torqu3e/Bonafizy/README.md

# Bonafizy

A project enabling control of Bonavita variable temperature kettles remotely over wifi. It adds an ESP8266 based wifi stack that runs a bit of C code to expose an HTTP REST API endpoint.

There's support to control both power and hold buttons individually as well as read the power or hold LED status. Bonafizy responds back with a JSON body making it easy to parse the output.

```
$ curl kettle.local/brew
{"message": "Brewing now!!!", "state": {"power": 1, "hold": 1}}
```

```
$ curl kettle.local/state
{"version": "0.1.2_mdns", "state": {"power": 0, "hold": 0}}
```

The name bonafizy is a portmanteau of Bonavita, WiFi and lazy. And by lazy I mean smart and resourceful :)

## Features
* Existent buttons continue to function
  * Kettle's in-built safety mechanisms still valid
* Control both POWER and HOLD individually
* Read both POWER and HOLD LED state
* Switch power and hold on with one request
* Wifi config via initial setup
* OTA updates
* mDNS

## Parts list
* [Bonavita kettle](https://bonavitaworld.com/products/category/Kettles) (of course). - 1
* [Wemos D1 Mini](https://www.aliexpress.com/item/32529101036.html) - 1
* [SparkFun Opto-isolator Breakout](https://www.sparkfun.com/products/9118) - 2
* Power Supply Unit [HLK-PM01](https://www.aliexpress.com/wholesale?catId=0&initiative_id=SB_20200329071832&SearchText=hlk+pm01) or a tiny USB adapter (old iPhone one?) - 1

## Tools and consumables
* Y1 screwdriver bit. iFixit has some good kits
* Jumper wires - few, ideally in different colours
* Micro usb cable
* Heatshrink tubing
* Hot glue gun
* Soldering iron, solder, flux, wire snips yada yada yada...

## Wiring Diagram
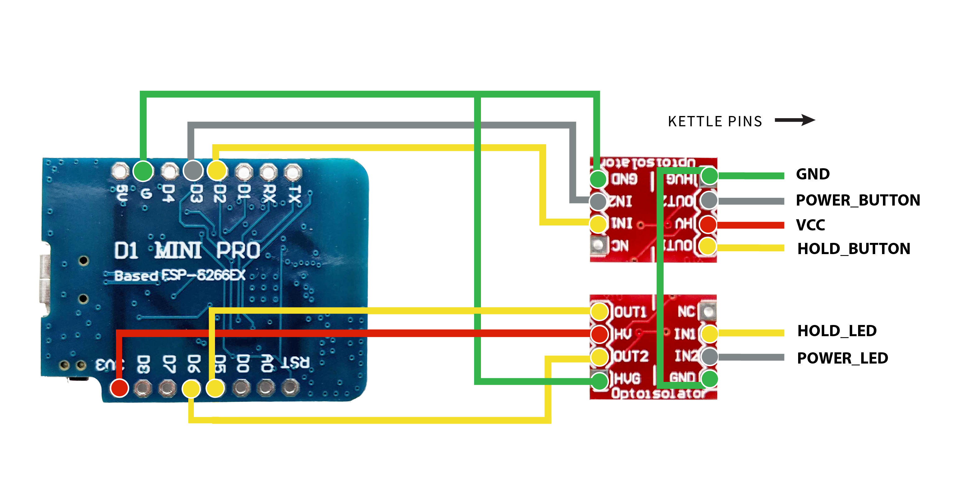
[picture p1: Bonafizy.png]
Bonafizy wiring diagram

Kettle wiring diagram

## Notes
First and foremost be extremely careful, there is mains supply open and accessible inside the kettle base. Do not open it if you are not comfortable and wary about operating around mains voltage. This can badly injure, maim or kill you. Highly suggest not plugging the kettle in with the base cover off to avoid getting electrocuted.
Now that the warning is out of the way, onto business...

The kettle's logic is reversed, which means pulling a pin low is considered as on. Don't know why, though it is mildly annoying. Secondly, the PCB has a very thorough conformal coating all over it (apparently not on all units which is rather strange) which makes probing or soldering anything a pain. You can scrape this coating off with a xacto knife or acetone, I just hard balled it with the soldering iron :P

Solder the D1 mini and opto coupler boards together per the wiring diagram. For the wires going to the kettle's PCB solder on about 8~10 inch long pieces onto the opto coupler boards. 

Flash the the sketch to the board as things will get more in situ after this. Arduino IDE with the ESP8266 board files added to it works well. Connect to `Bonafizy_AP` after reboot. Configure
wifi details and wait for the board to establish connection to the configured AP. If this fails, the `Bonafizy_AP` should broadcast again, so try reconfiguring.
Now is a good time to test the API endpoint is responding. Toggling the LED pins by pulling them high/low should reflect on the /state endpoint.

Loosely place everything in the base and wire/route things however it seems appropriate. Solder the wires to the specific pins on the kettle (remember - conformal coating).

Solder two wires to the AC pins of the PSU and heatshrink them in place, making sure no bits are exposed. Next place the PSU in the base and try to put the cover back on to check placement and fitment. Once content, hot glue the PSU in place. Cut a micro USB cable at the USB A port end, peel the outer sheath, solder the +5v and GND cables to appropriate pins on the PSU. Connect the micro USB end to D1 mini. Solder the AC power wires to the power board on the kettle.

At this point things should be at a place to test the whole setup. Tighten a couple of screws to hold the base in place, the center socket that the kettle sits on tends to come loose so locate it correctly before tightening the screws. Easiest way to test is using the `test_endpoints.sh` script.

If everything is good. Undo the screws and coat all the points that were soldered on the kettle PCBs as well as the D1 mini board and the opto coupler boards with conformal coat/lacquer/clear nailpaint. Tighten up all the screws again. Run tests one more time and you should be good to go.

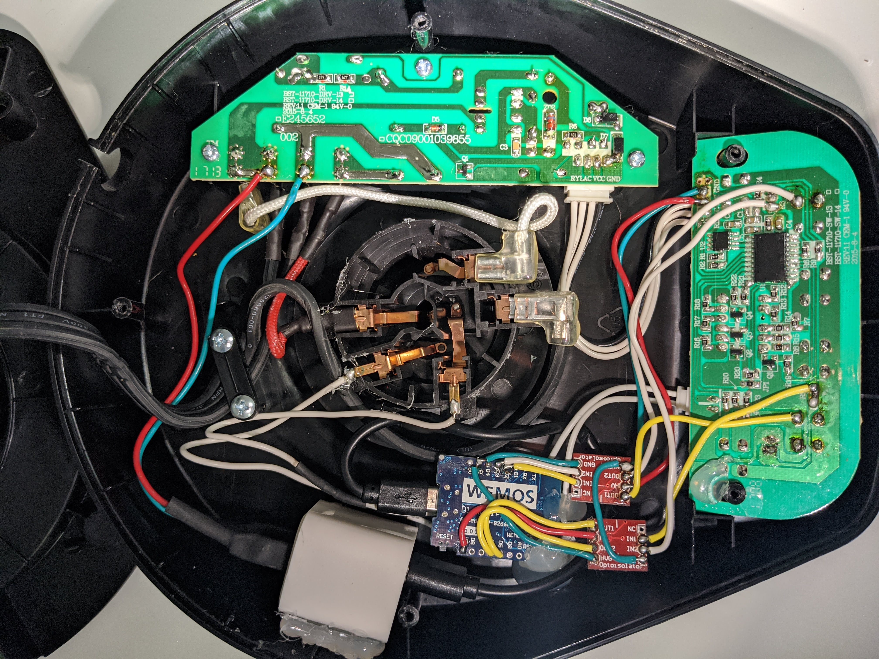
[picture p2: bonafizy_hardware.jpg]
All done


## Endpoints
```
# Adding ?pretty or ?pretty=true to any endpoint will pretty print the response

/state          - retrieve kettle state
/brew           - turn power and hold on at once
/power/off      - turn kettle off
/power/on       - power on
/hold/off       - switch hold off
/hold/on        - invert ^
/bonafizy/admin - reset wifi configuration (POST with body - '{"factory_reset":"true"}')
/coffee         - Hit it!

```
## Running tests

This section is mostly for me since I come back to the project rarely enough to forget about this.

```
$ pip install -r requirements.txt

$ pytest --html=test_report.html test_sample.py 

```

## Pitfalls
* The **ESP8266 has to be powered on before the kettle**, else the kettle misbehaves. Initial state of ESP8266 pins take a while to settle during bootup and if ketlle buttons are pulled low during bootup it gets all weird about it.
* **Arduino** IDE **board selection** must be **Lolin Wemos D1 Mini or Pro** else pin mappings will be completely off and nothing will function as expected.
  * Simplest test for above, set `wait_time_ms` to 500 and test voltage between power/hold pin and ground while toggling the pin. If it doesn't swing between 0 (more like 1.3v) and 5v check your board settings.

## Musings
* Works for sure with BV382510V, quite likely will work with other variable temperature ones listed at http://bonavitaworld.com/product-categories/kettles.
* ILD213T opto coupler [datasheet](https://www.vishay.com/docs/83647/ild205t.pdf)
* Smallest USB charger you can find. The Apple 5w charger from olden days barely fits in there, takes some cutting of the base. An [HLK-PM01](https://www.aliexpress.com/wholesale?catId=0&initiative_id=SB_20200329071832&SearchText=hlk+pm01) is the [best option](https://lygte-info.dk/review/Power%20Mains%20to%205V%200.6A%20Hi-Link%20HLK-PM01%20UK.html) I've found that's currently in use on at least one kettle.
* Kettle originally contains an ATMEL 24C02 EEPROM and a SONIX SN8P2722 microcontroller.
* Hold LED state is read from the microcontroller pin because the voltage drop across the resistor is too small for the threshold of the opto-coupler. This was the most time consuming part of figuring the hardware setup.
* **Strong personal recommendation** for a [hobby soldering iron](https://amzn.to/3ixwkXy)
