torqu3e/Bonafizy/test_report.html

# test_report.html

Report generated on 25-Nov-2022 at 15:39:25 by pytest-html (https://pypi.python.org/pypi/pytest-html) v3.2.0

## Environment

Packages | {"pluggy": "1.0.0", "pytest": "7.2.0"}
Platform | macOS-13.0.1-arm64-arm-64bit
Plugins | {"html": "3.2.0", "metadata": "2.0.4"}
Python | 3.9.6

## Summary

2 tests ran in 19.30 seconds.

(Un)check the boxes to filter the results.

2 passed, 0 skipped, 0 failed, 0 errors, 0 expected failures, 0 unexpected passes

## Results

Result | Test | Duration | Links
No results found. Try to check the filters
Passed | test_sample.py::test_bonafizy | 18.13
------------------------------Captured stdout call------------------------------ Testing power/off... Testing hold/off... Testing hold/on... Testing power/on... Testing hold/off... Testing hold/on... Testing hold/on... Testing power/off... Testing brew... Testing brew... Testing power/off... Testing power/on... Testing brew... Testing power/off... Testing state...
Passed | test_sample.py::test_httpcp | 1.12
No log output captured.
