torqu3e/Bonafizy/bonafizy.ino

/* Sketch - Bonafizy
 * Version - 0.1.6
 * Author - Tejinder Singh
 *
 * TODO:
    - Brew coffee!
 */

#include <ArduinoJson.h>
#include <ArduinoOTA.h>
#include <ESP8266WebServer.h>
#include <ESP8266WiFi.h>
#include <ESP8266mDNS.h>
#include <WiFiManager.h>

//------------------------------------------
#define HOSTNAME "kettle"
//------------------------------------------

#define FW_VER "0.1.6"
#define POWER_BUTTON D3 // Pin attached to kettle's power button
#define HOLD_BUTTON D2  // Pin attached to kettle's hold button
#define POWER_LED D6    // Pin attached to kettle's power LED
#define HOLD_LED D5     // Pin attached to kettle's hold LED
#define BUILTIN_LED D4

const int wait_time_ms = 100;

WiFiManager wifiManager;
ESP8266WebServer server(80);

void setup()
{
  pinMode(POWER_BUTTON, OUTPUT);
  digitalWrite(POWER_BUTTON, HIGH);
  pinMode(HOLD_BUTTON, OUTPUT);
  digitalWrite(HOLD_BUTTON, HIGH);
  pinMode(POWER_LED, INPUT);
  pinMode(HOLD_LED, INPUT);

  Serial.begin(115200);
  Serial.print("");
  Serial.println("Bonafizy kettle automator");
  Serial.print("Firmware version: ");
  Serial.println(FW_VER);

  Serial.println("Starting wifi manager");
  wifiManager.autoConnect("Bonafizy_AP");
  Serial.println("Should be on wifi at this point.");

  Serial.println("");
  Serial.print("Connected to ");
  Serial.print(WiFi.SSID());
  Serial.print(" at ");
  Serial.println(WiFi.localIP());
  Serial.println("");

  Serial.println("Setting up mDNS responder...");
  uint8_t mdns_counter = 0;
  while (!MDNS.begin(HOSTNAME))
  {
    delay(1000);
    Serial.print(".");
    if (mdns_counter >= 5)
    {
      Serial.println("mDNS responder setup failed, rebooting...");
      ESP.reset();
    }
    mdns_counter++;
  }
  MDNS.addService("http", "tcp", 80);
  Serial.print("mDNS responder up, responding at ");
  Serial.printf("%s.local", HOSTNAME);
  Serial.println("");

  ArduinoOTA.setHostname(HOSTNAME);
  ArduinoOTA.onStart([]()
                     {
    String type;
    if (ArduinoOTA.getCommand() == U_FLASH) {
      type = "sketch";
    } else { 
      type = "filesystem";
    }

    Serial.println("Start updating " + type); });
  ArduinoOTA.onEnd([]()
                   { Serial.println("\nEnd"); });
  ArduinoOTA.onProgress([](unsigned int progress, unsigned int total)
                        { Serial.printf("Progress: %u%%\r", (progress / (total / 100))); });
  ArduinoOTA.onError([](ota_error_t error)
                     {
    Serial.printf("Error[%u]: ", error);
    if (error == OTA_AUTH_ERROR) {
      Serial.println("Auth Failed");
    } else if (error == OTA_BEGIN_ERROR) {
      Serial.println("Begin Failed");
    } else if (error == OTA_CONNECT_ERROR) {
      Serial.println("Connect Failed");
    } else if (error == OTA_RECEIVE_ERROR) {
      Serial.println("Receive Failed");
    } else if (error == OTA_END_ERROR) {
      Serial.println("End Failed");
    } });
  ArduinoOTA.begin();

  server.on("/", HTTP_GET, HandleRoot);
  server.on("/state", HTTP_GET, api_handler);
  server.on("/brew", HTTP_GET, api_handler);
  server.on("/power/on", HTTP_GET, api_handler);
  server.on("/power/off", HTTP_GET, api_handler);
  server.on("/hold/on", HTTP_GET, api_handler);
  server.on("/hold/off", HTTP_GET, api_handler);
  server.on("/bonafizy/admin", HTTP_POST, bonafizy_admin);
  server.on("/coffee", HTTP_GET, htcpcp);
  server.onNotFound(HandleNotFound);
  server.begin();
  Serial.print("HTTP server started on ");
  Serial.print(HOSTNAME);
  Serial.println(" at ip " + WiFi.localIP().toString());
}

void api_handler()
{
  String message = "";
  const size_t capacity = 2 * JSON_OBJECT_SIZE(2) + 100;
  DynamicJsonDocument doc(capacity);

  if (server.uri() == "/power/off")
  {
    doc["message"] = power_off();
  }
  else if (server.uri() == "/power/on")
  {
    doc["message"] = power_on();
  }
  else if (server.uri() == "/hold/on")
  {
    doc["message"] = hold_on();
  }
  else if (server.uri() == "/hold/off")
  {
    doc["message"] = hold_off();
  }
  else if (server.uri() == "/brew")
  {
    doc["message"] = brew();
  }
  else if (server.uri() == "/state")
  {
    doc["version"] = FW_VER;
  }

  JsonObject state = doc.createNestedObject("state");
  state["power"] = 1 - digitalRead(POWER_LED);
  state["hold"] = 1 - digitalRead(HOLD_LED);
  if (server.hasArg("pretty") && (server.arg("pretty") != "false"))
  {
    serializeJsonPretty(doc, message);
  }
  else
  {
    serializeJson(doc, message);
  }
  Serial.println(message);
  server.send(200, "application/json", message);
}

void blip(String function)
{
  if (function == "power")
  {
    digitalWrite(POWER_BUTTON, LOW);
    delay(wait_time_ms);
    digitalWrite(POWER_BUTTON, HIGH);
  }
  else if (function == "hold")
  {
    digitalWrite(HOLD_BUTTON, LOW);
    delay(wait_time_ms);
    digitalWrite(HOLD_BUTTON, HIGH);
  }
}

String power_on()
{
  if (digitalRead(POWER_LED) == 1)
  {
    blip("power");
    delay(wait_time_ms);
    return ("Kettle powered on");
  }
  else
  {
    return ("Kettle already on");
  }
}

String power_off()
{
  if (digitalRead(POWER_LED) == 0)
  {
    blip("power");
    return ("Kettle powered off");
  }
  else
  {
    return ("Kettle already off");
  }
}

String brew()
{
  if (digitalRead(POWER_LED) == 0 && digitalRead(HOLD_LED) == 1)
  {
    blip("hold");
    return ("Kettle was on, set hold temperature on");
  }
  else if (digitalRead(POWER_LED) == 1)
  {
    blip("power");
    delay(wait_time_ms);
    blip("hold");
    return ("Brewing now!!!");
  }
  else
  {
    return ("Kettle already brewing");
  }
}

String hold_on()
{
  if (digitalRead(POWER_LED) == 0)
  {
    if (digitalRead(HOLD_LED) == 1)
    {
      blip("hold");
      return ("Hold temperature on");
    }
    else
    {
      return ("Hold temperature already on");
    }
  }
  else
  {
    return ("Kettle is off, cannot turn hold on");
  }
}

String hold_off()
{
  if (digitalRead(POWER_LED) == 0)
  {
    if (digitalRead(HOLD_LED) == 0)
    {
      blip("hold");
      return ("Hold temperature off");
    }
    else
    {
      return ("Hold already off");
    }
  }
  else
  {
    return ("Kettle is off, cannot turn hold off");
  }
}

void bonafizy_admin()
{
  DynamicJsonDocument doc(1024);
  deserializeJson(doc, server.arg("plain"));
  String message = "";
  if (doc["factory_reset"] == "True" || doc["factory_reset"] == "true")
  {
    message += "{\"message\": \"Resetting ESP, Connect to AP after reboot for configuration\"}";
    Serial.println(message);
    server.send(200, "application/json", message);
    delay(500);
    wifiManager.resetSettings();
    delay(500);
    ESP.reset();
  }
  message += "{\"message\": \"Unrecognized instruction\"}";
  Serial.println(message);
  server.send(422, "application/json", message);
}

void htcpcp()
{
  String message = "<html><h3><a href=\"https://tools.ietf.org/html/rfc2324#section-2.3.2\">I'm a Teapot</a></h2></html>";
  Serial.println("I'm a Teapot https://tools.ietf.org/html/rfc2324#section-2.3.2");
  server.send(418, "text/html", message);
}

void HandleRoot()
{
  String message = "<html>";
  message += "<h2>Bonafizy</h2>";
  message += "<body>Wifi endpoint for the Bonavita kettle</body>";
  message += "</html>";
  server.send(200, "text/html", message);
}

void HandleNotFound()
{
  String message = "File Not Found\n\n";
  message += "URI: ";
  message += server.uri();
  message += "\nMethod: ";
  message += (server.method() == HTTP_GET) ? "GET" : "POST";
  message += "\nArguments: ";
  message += server.args();
  message += "\n";
  for (uint8_t i = 0; i < server.args(); i++)
  {
    message += " " + server.argName(i) + ": " + server.arg(i) + "\n";
  }
  server.send(404, "text/html", message);
}

void loop()
{
  MDNS.update();
  server.handleClient();
  ArduinoOTA.handle();
}
