torqu3e/Bonafizy/(commit log)

2020-03-22 First pass to bunch of updates (#2)
    * initial uP scratch
    * Wifi setup, HTTP server, pin toggle functions buttoned up
    to all interact.
    This is a good baseline to start from, needs refining and POST
    handling for proper REST interface.
    * Setup OTA
    * Updated pins for better opto-isolator wiring
    Initialize out pins to high
    Added brew endpoint
    State with nested message in each response
    corrected JSON output
    0.1.0 first version live on Kettle
    * Nested handlers and qa
    Changed control flow through an api handler, to kettle control. #DRY
    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
    [bonafizy.ino]
2020-04-13 Wifi manager (#5)
    Allows setting up wifi credentials during initial setup instaed of hard coded into code,
    making reuse easier.
    Allow reset of wifi credentials
    Update test script
    Update readme
    HTCPCP endpoint
    [bonafizy.ino]
2020-08-14 Wiring diagram fix
2020-11-10 ArduinoJSON, pytest and CC-BY-NC-SA (#6)
    * ArduinoJSON, pytest and CC-BY-NC-SA
    * Switching to ArduinoJSON library to construct cleaner JSON response
    body as well as pretty print
    * Switching from janky bash script for testing to pytest. Makes it more
    robust and consistent
    * License to CC-BY-NC-SA
    * Moving kettle endpoint lookup to hostname
2022-11-25 Conditional pretty printing (#7)
    * Allowing conditional pretty printing
    Correcting brew logic slightly
    * set hostname over OTA
    lynting
    * Update tests and readme
    * doc
    [bonafizy.ino, test_sample.py]
